Ted1702/First_Repository/prima.jpeg

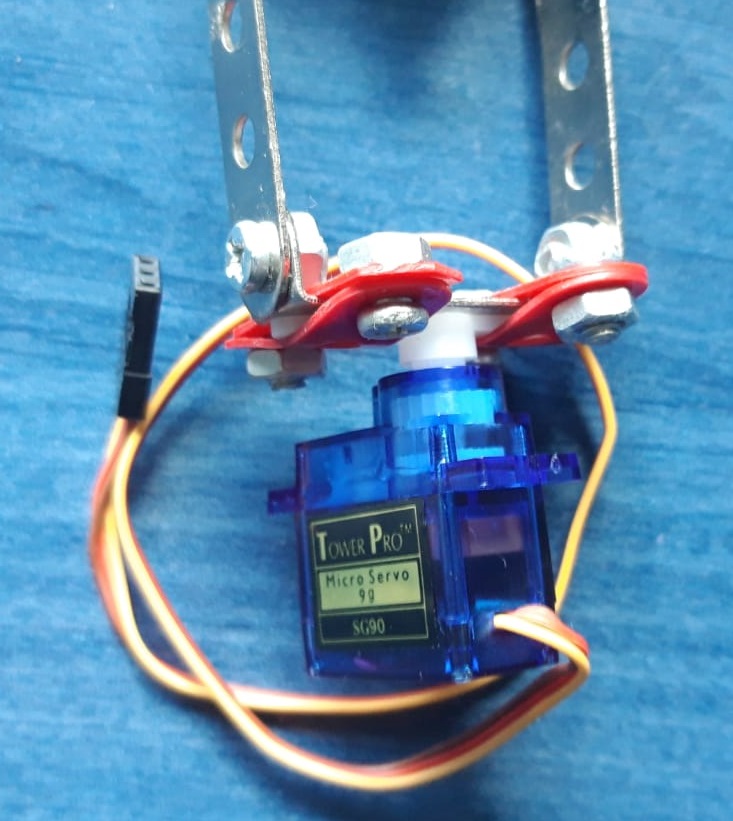
prima.jpeg
