Ted1702/First_Repository/figura 1-3.PNG

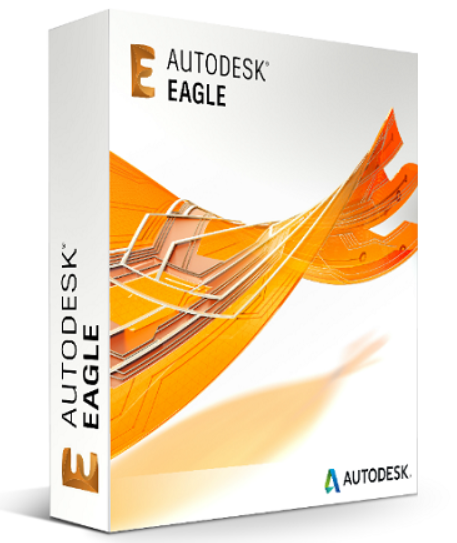
figura 1-3.PNG
