Ted1702/First_Repository/Prezentare_Proiect_Diploma_Lina_Teodor.pptx

Proiect de licență

Robot autonom cu braț mecanic și cameră video

Conducător științific Absolvent
Conf.Dr.Ing. Octaviana DATCU Teodor LINA

## Scopul proiectului și motivația

- Scopul: dezvoltarea unui robot controlat de la distanță capabil de recunoaștere video și îndepărtarea de obstacole.
- Motivația: realizarea unor sisteme hardware comandate de programe software

Notes: Scopul proiectului este reazilarea unui robot capabil să:
Se deplaseze în locuri mai greu accesibile omului
Să poată oferi imagini live de la fața locului
Să poată îndepărta obiecte ușoare care blochează drumul pe unde se dorește deplasarea robotului

Această temă a fost aleasă în scopul creării unui sistem embedded, care îmbină cunoștințele de electronică cu cele de programare.

## Contribuții

- Alegerea componentelor necesare dezvoltării proiectului
- Realizarea schemelor bloc pentru robot și telecomanda cu care se controlează robotul
- Construcția robotului
- Realizarea unui PCB pentru telecomandă
- Construcția brațului mecanic din piese metalice
- Realizarea unor programe software pentru robot și telecomandă

## Slide 4

Diagrama Gantt a proiectului

| Oct. | Nov. | Dec. | Ian. | Feb. | Mar. | Apr. | Mai | Iun.
Planificare inițială
Telecomandă-Schemă electrică
Robot-Schemă electrică
Telecomandă-PCB
Telecomandă-Software
Telecomandă-Asamblare și testare
Construcție braț mecanic
Construcție robot
Robot-Software
Robot-Asablare și testare
Testare sistem
Documentație scrisă

## Scheme Bloc Hardware

- În continuare vor fi detaliate:
1. Schema electrică a telecomenzii
2. Schema electrică a robotului

## Slide 6

Schema electrică a telecomenzii robotului

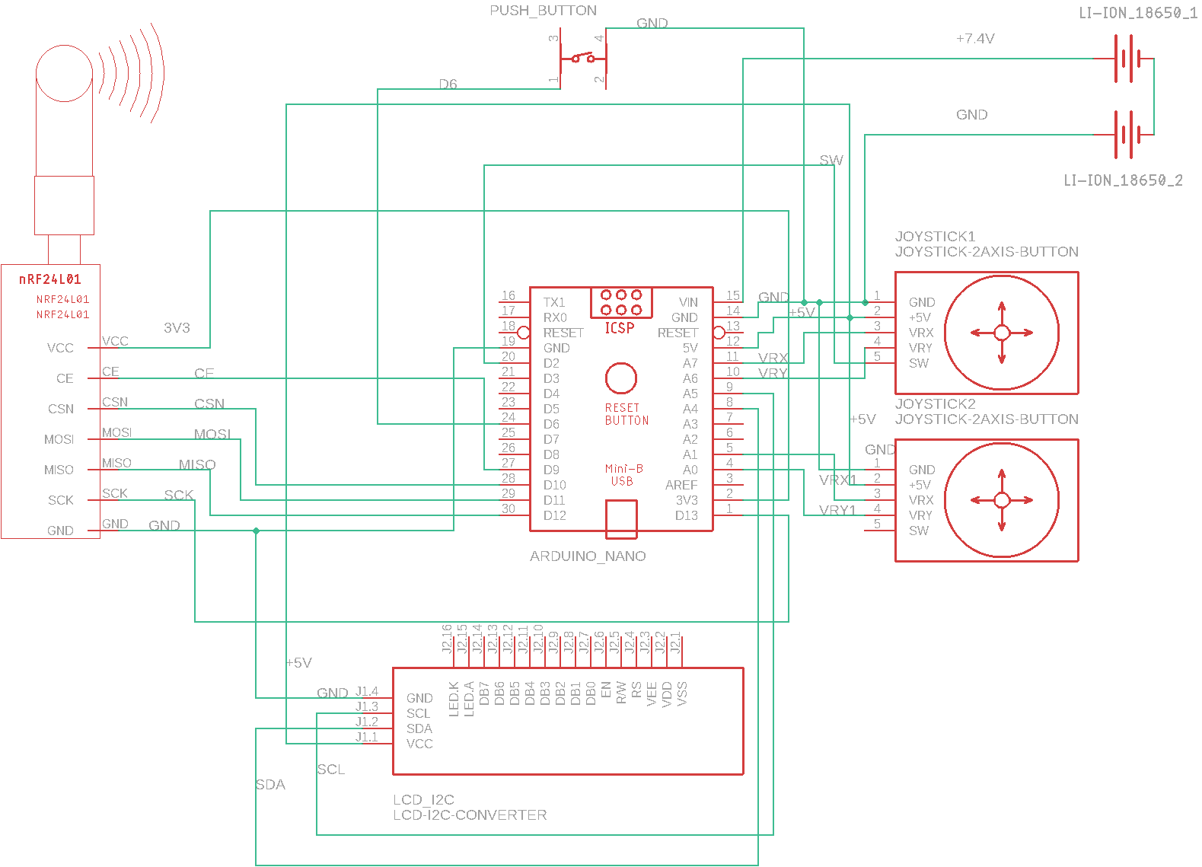
[picture p16: figure]

Sursă alimentare telecomandă

Joystick robot

Joystick braț mecanic

Transmițător radio

Ecran LCD

## Slide 7

Schema electrică a robotului

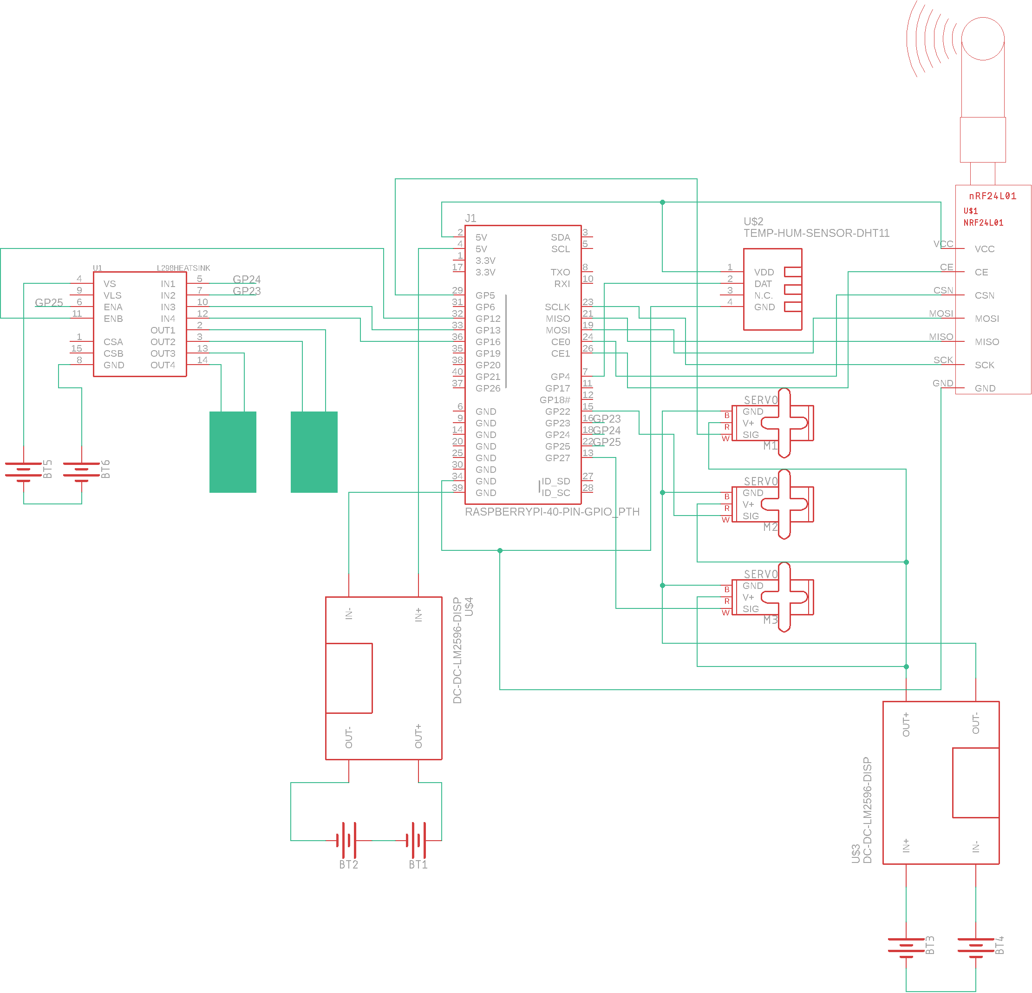
[picture p17: figure]
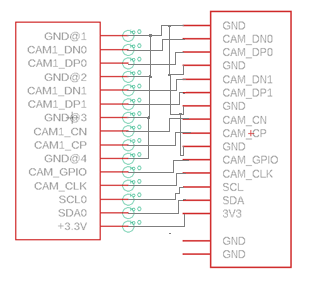
[picture p18: figure]

Transmițător radio

Motoare DC

Coborâtoare de tensiune
LM2596

Sursă alimentare braț mecanic

Sursă alimentare motoare DC

Sursă alimentare Raspberry Pi

## Realizarea comunicației wireless între robot și telecomandă cu ajutorul modulelor NRF24L01+

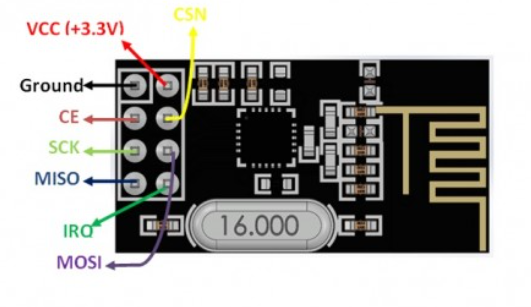
[picture p19: figure]

Protocolul Enhanced Shock Burst

Preambul | Adresă | Control pachet | Conținut pachet | CRC

1 Byte

3-5 Byte

9 Byte

0-32 Byte

1-2 Byte

Lungime conținut pachet | ID pachet | Fără pachet ACK

6 Byte

2 Byte

1 Byte

## Controlul motoarelor DC cu ajutorul punții H duală L298N

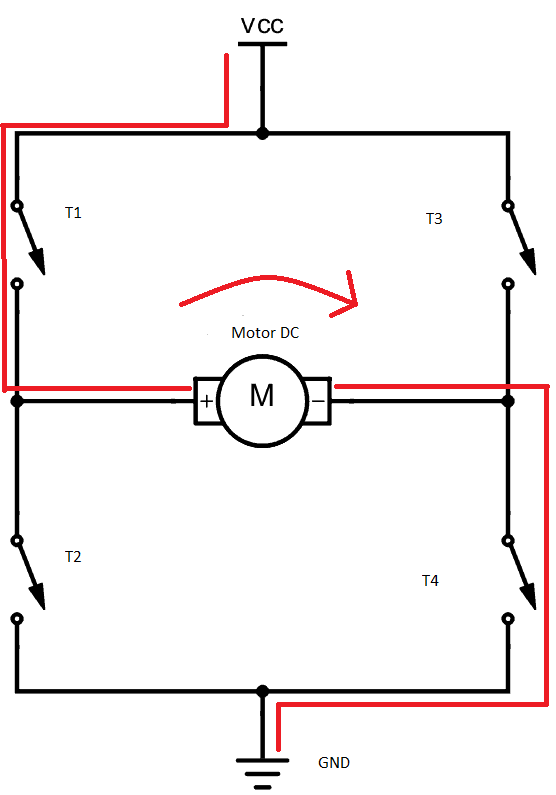
[picture p20: figure]
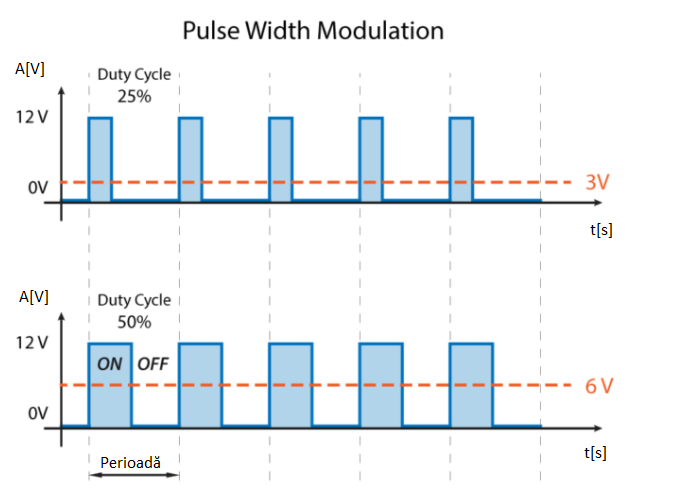
[picture p21: figure]
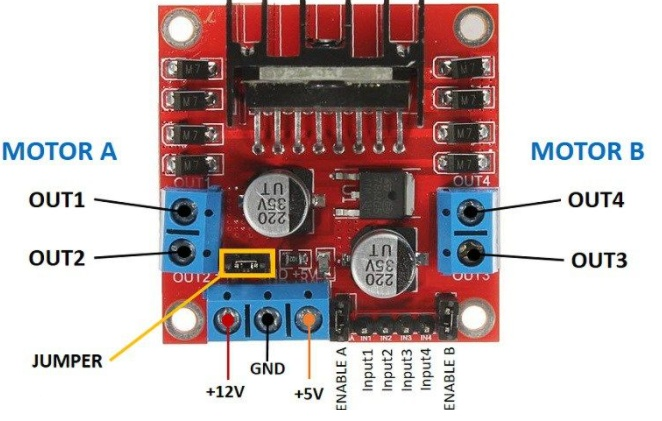
[picture p22: figure]

## Servo-motoarele micro SG90 ale brațului mecanic

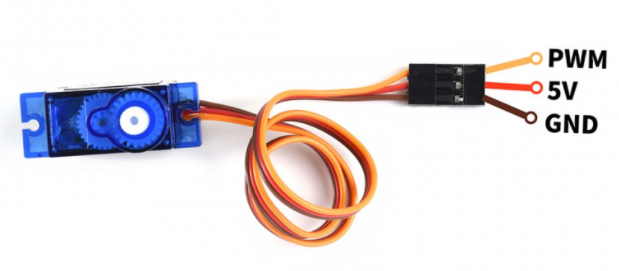
[picture p23: figure]
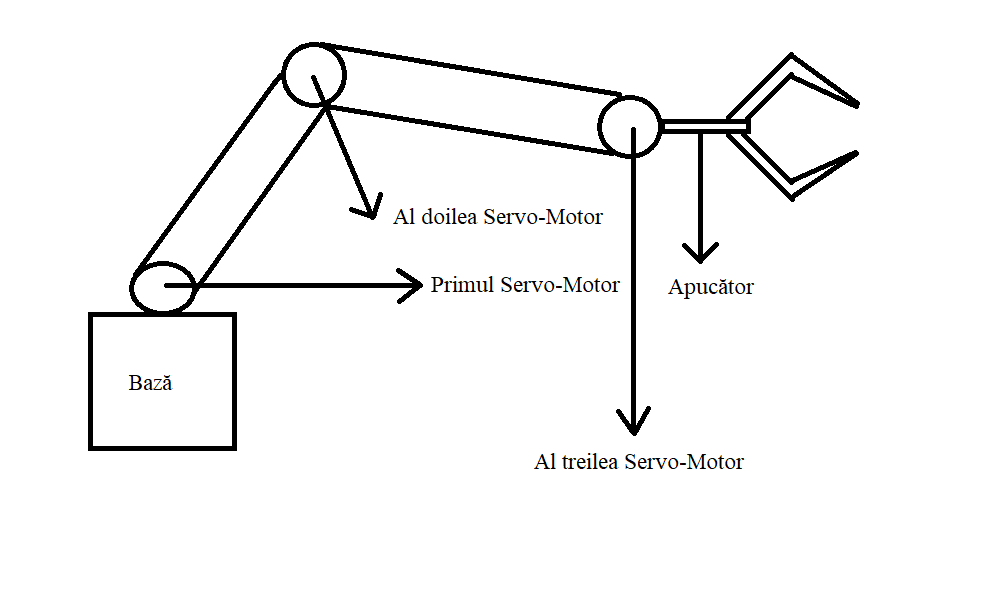
[picture p24: figure]
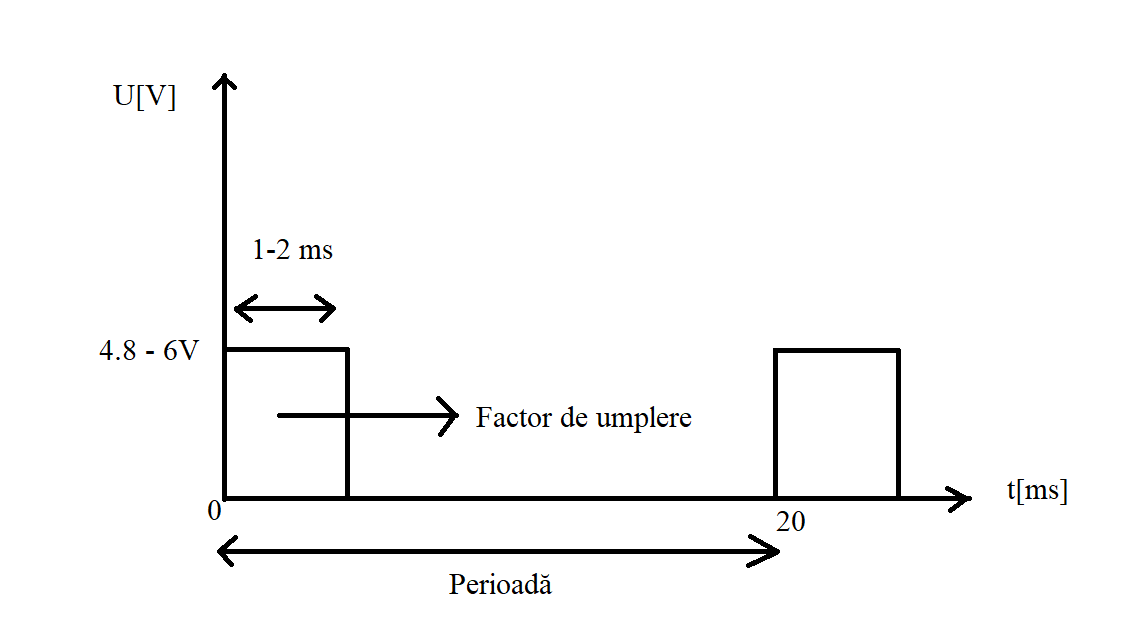
[picture p25: figure]

## Slide 11

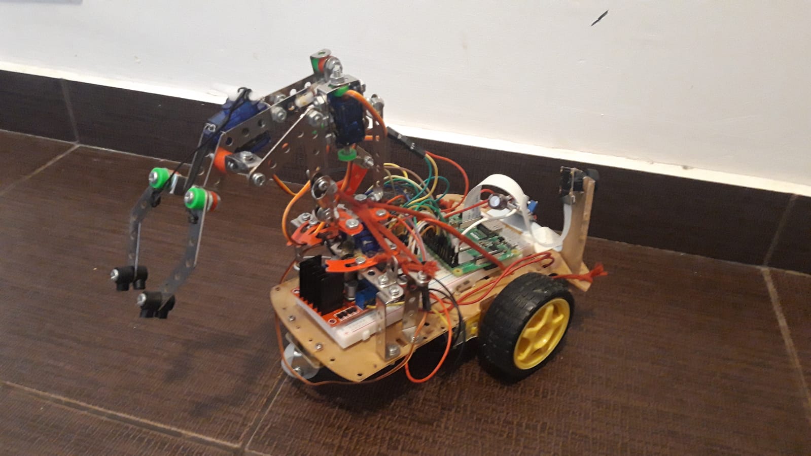
[picture p26: figure]

Machetă Robot

Poziție inițială

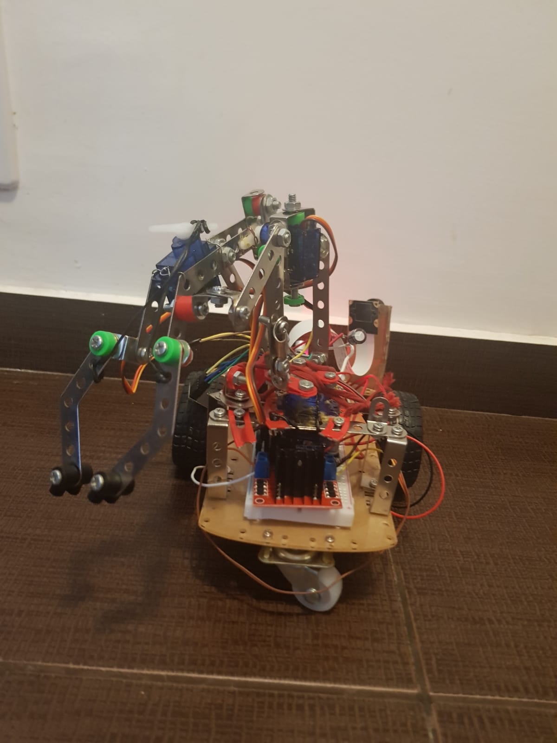
[picture p27: figure]

Deplasare la dreapta

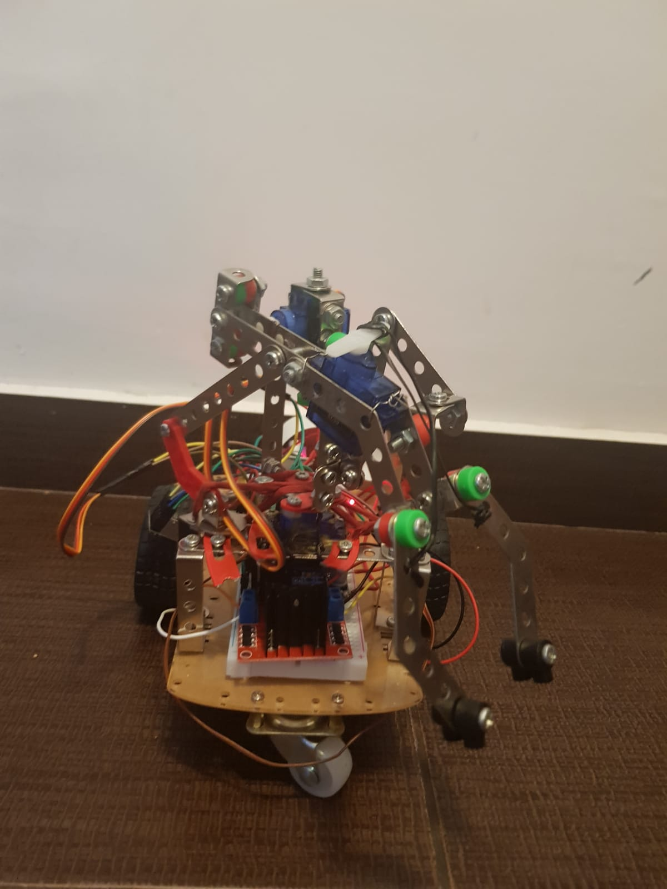
[picture p28: figure]

Deplasare la stânga

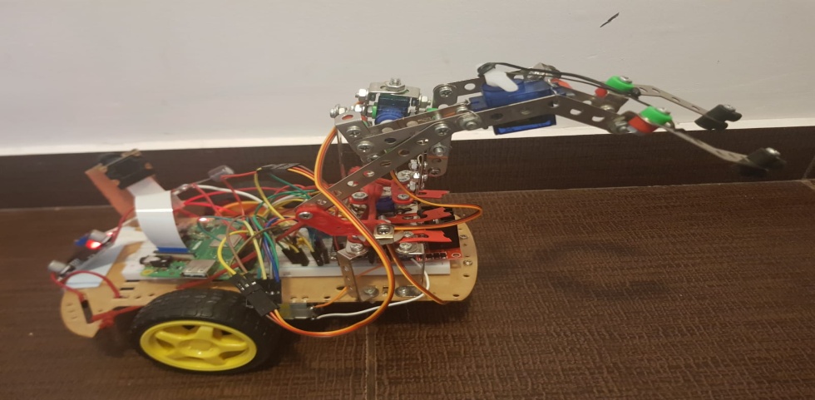
[picture p29: figure]

Deplasare în sus

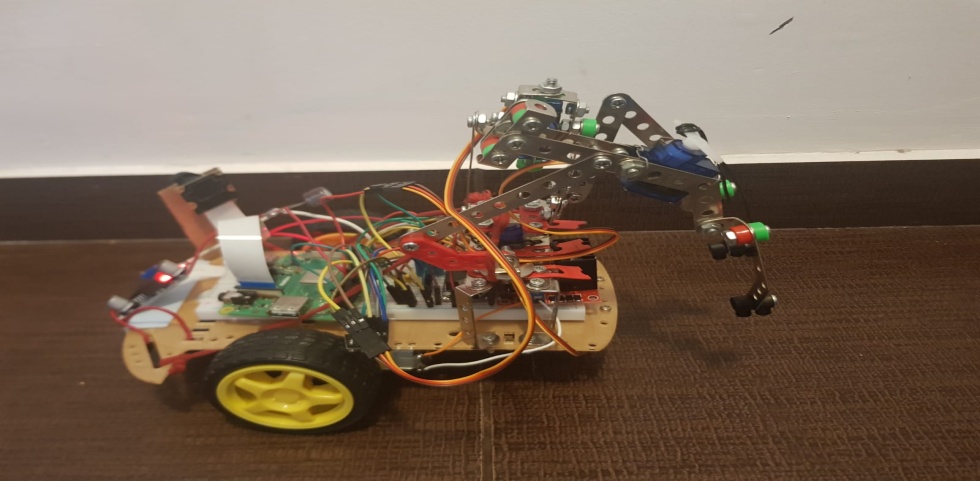
[picture p30: figure]

Deplasare în jos

## Măsurarea temperaturii și umidității cu senzorul digital DHT 11

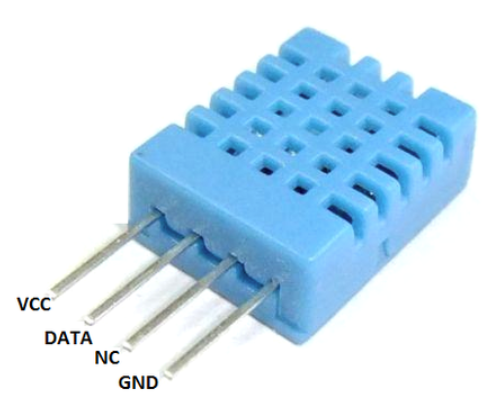
[picture p31: figure]
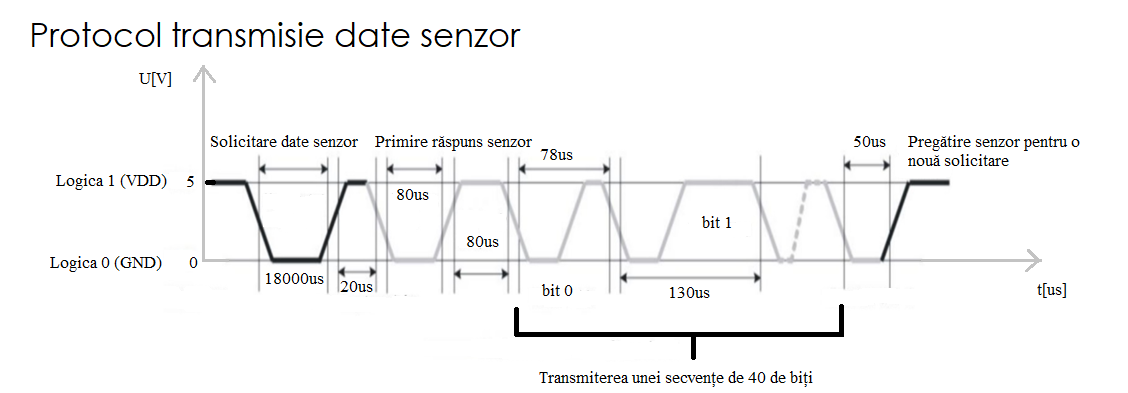
[picture p32: figure]

## Video stream realizat cu un modul de cameră compatibil cu Raspberry Pi

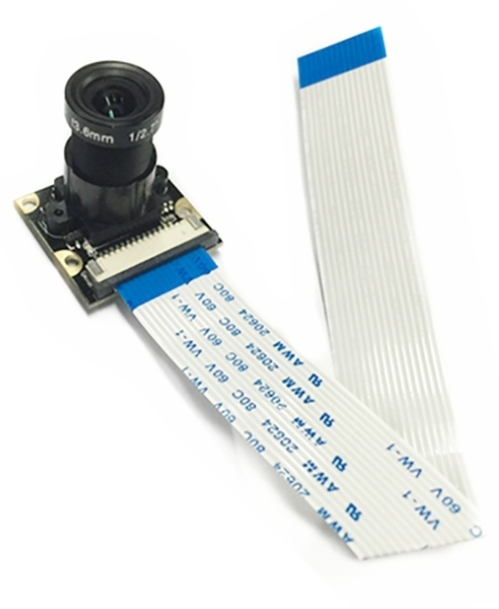
[picture p33: figure]

- format MJPEG
- 24 cadre/secundă
- rezoluție de 640x480 pixeli
- debit binar 1MB/secundă

## Organigrama codului sursă

Telecomandă

Start

Robot

Start

Inițializare cameră video

Redare stream video

Pregătire NRF24l01+

Buton apăsat

Pregătire NRF24l01+

DA

DA

Trimitere mesaj ’’stop’’

Recepționare mesaj ’’stop’’

Trimitere date senzor DHT11

NU

NU

Recepționare coordonate
de deplasare

Recepționare date de la robot

Trimitere coordonate de deplasare

Afișarea datelor recepționate.

Deplasare robot/braț mecanic

## Slide 15

Pachetele de date transmise între robot și telecomandă

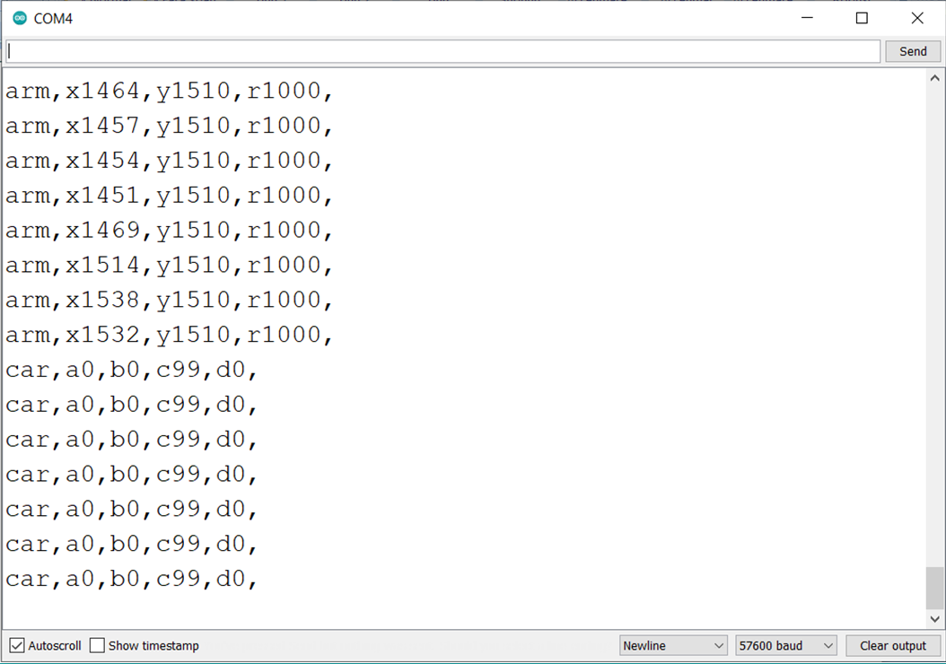
[picture p34: figure]
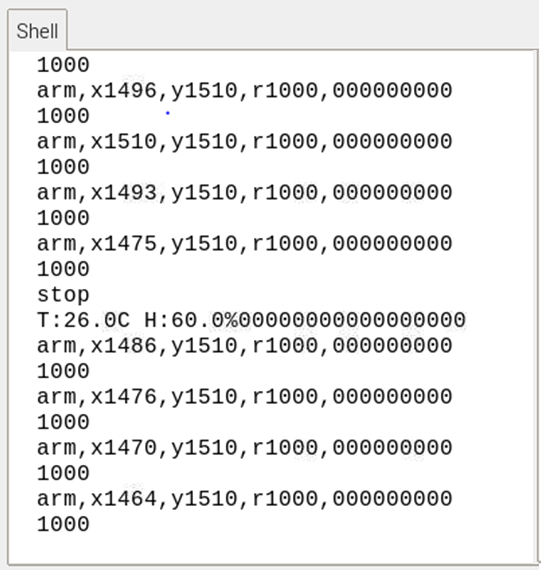
[picture p35: figure]

## Slide 16

Demonstrație funcționalități robot

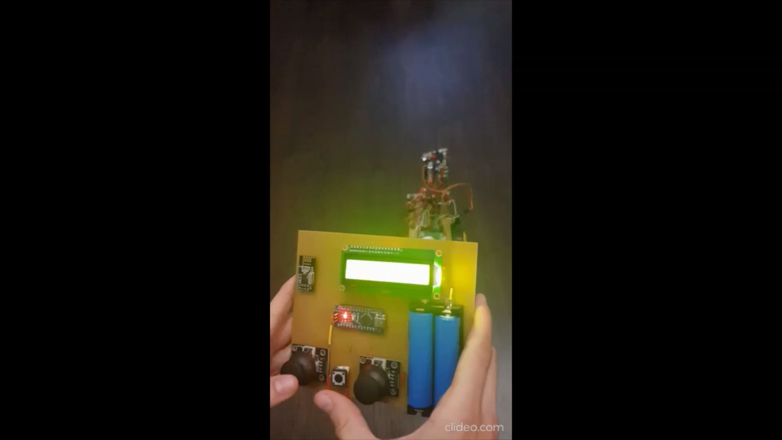
[picture p36: figure]

## Concluzii

Îndeplinirea obiectivului propus, după rezolvarea problemelor apărute:
- alimentarea de 3.3V a transmițătorului NRF24L01+
- alimentarea de 5V a plăcii de dezvoltare Raspberry Pi
- corecția mișcării servo-motoare SG90
- corecția suportului de acumulatori la PCB-ul telecomenzii
- corecția suportului de braț mecanic
