Ted1702/First_Repository/2021_Licenta_Inscriere_Teodor_LINA.docx

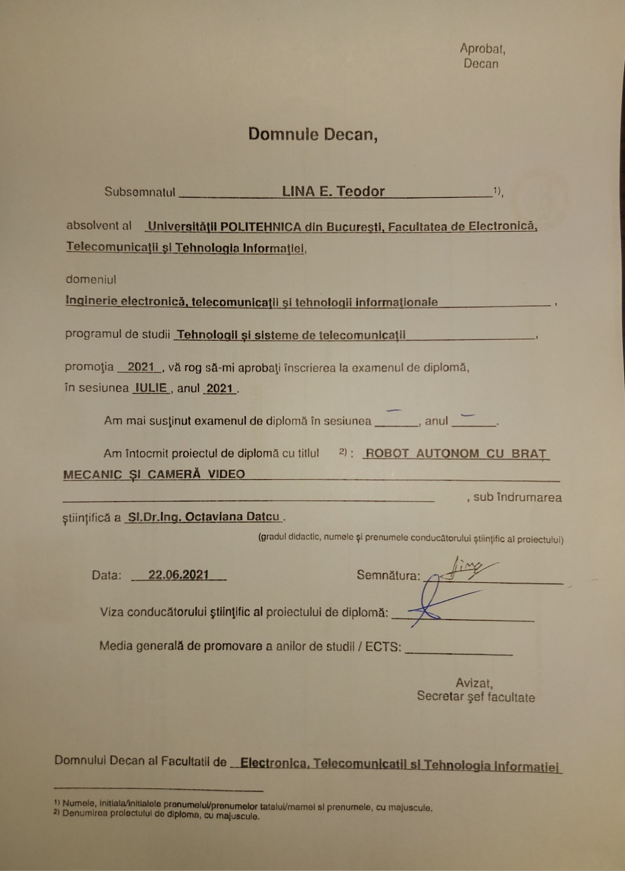
[picture p41: figure]
file:///C:/Users/User/Downloads/2021_Licenta_Inscriere_Teodor_LINA
