Ted1702/First_Repository/1-12.png

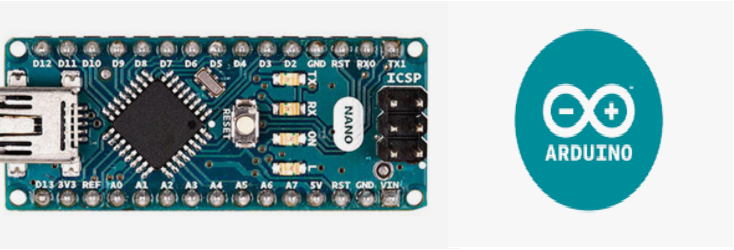
1-12.png
