Ted1702/First_Repository/1-19.png

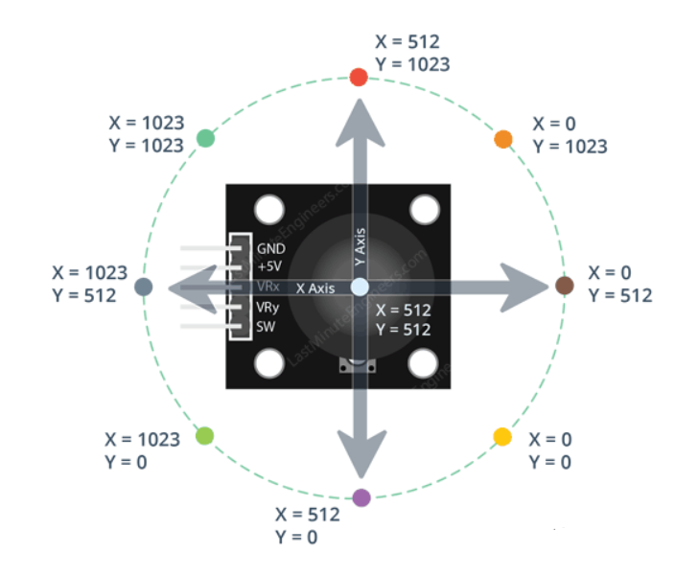
1-19.png
