Ted1702/First_Repository/3-3.png

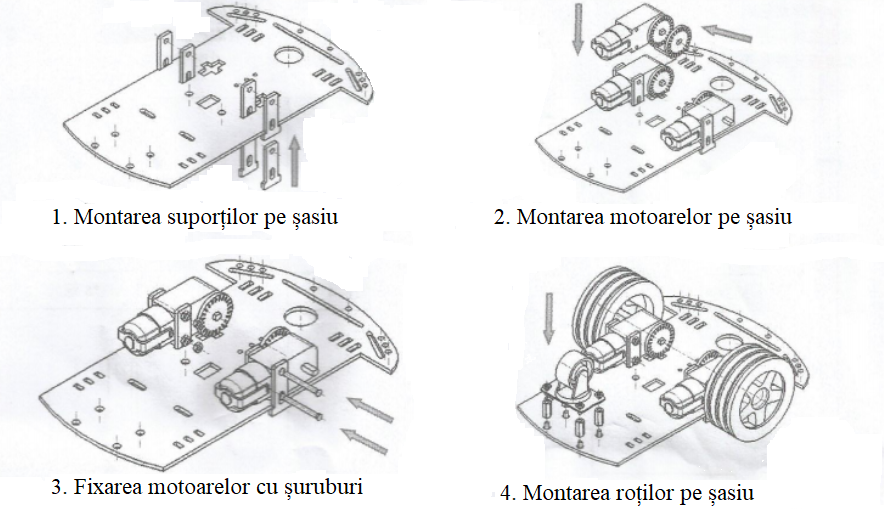
3-3.png
