Ted1702/First_Repository/doua.jpeg

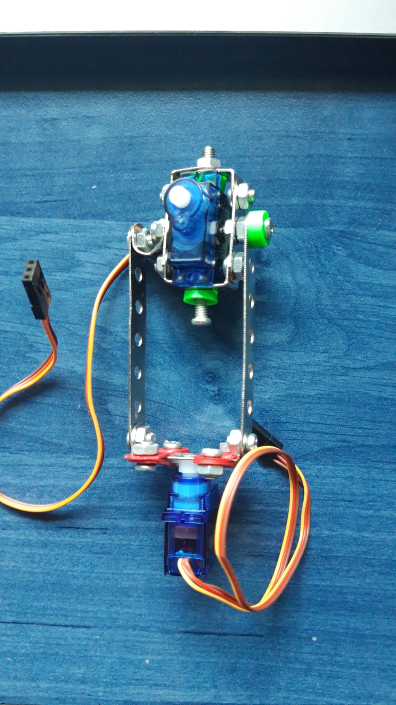
doua.jpeg
