Ted1702/First_Repository/figura1-13.png

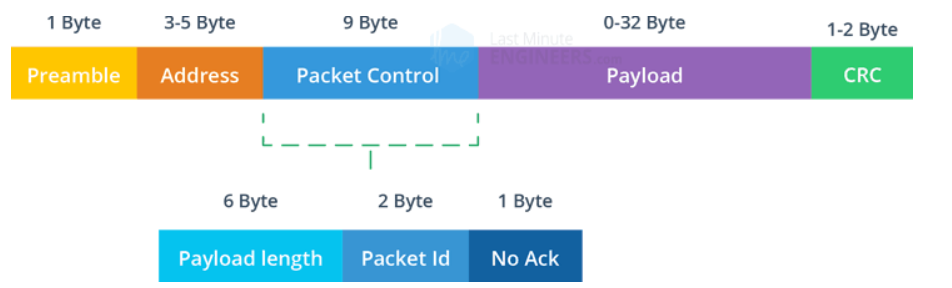
figura1-13.png
