Ted1702/First_Repository/figura1-15.png

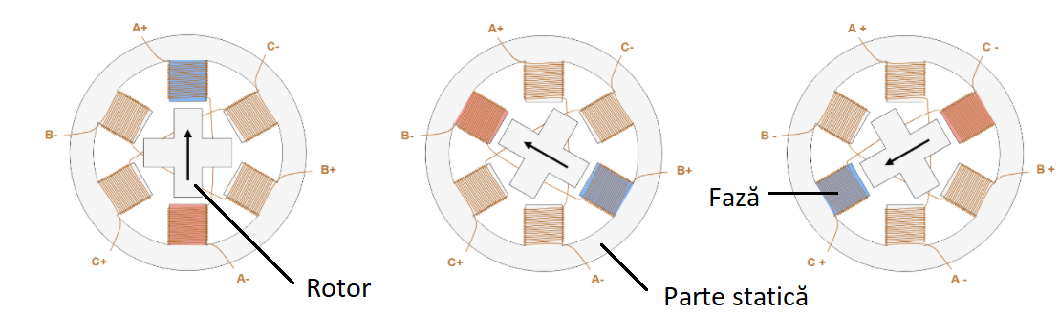
figura1-15.png
