Ted1702/First_Repository/figura 2-2.png

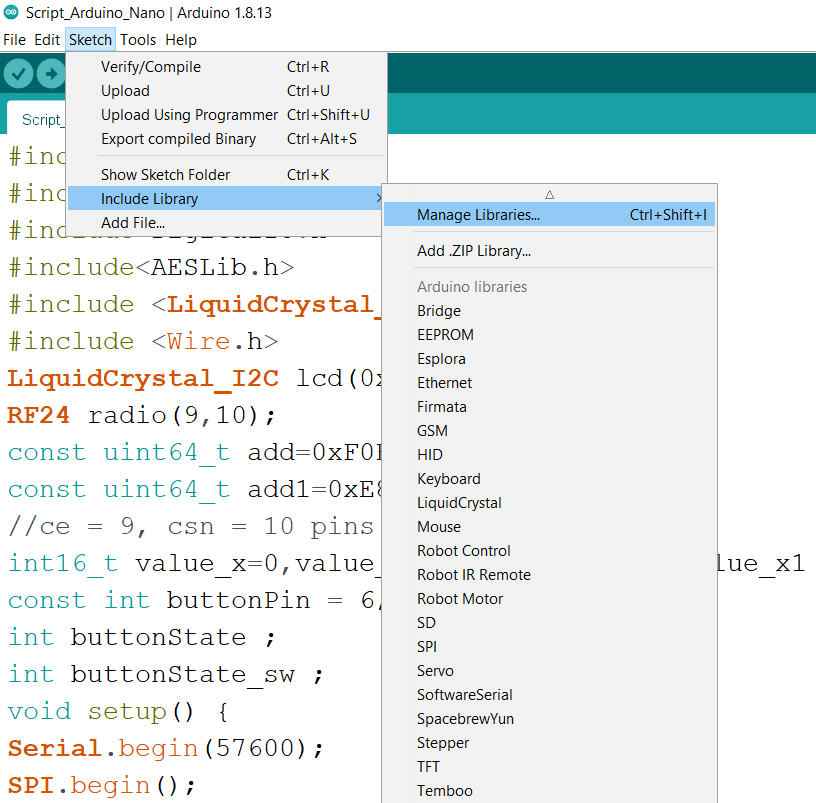
figura 2-2.png
