Ted1702/First_Repository/figura 2-3.png

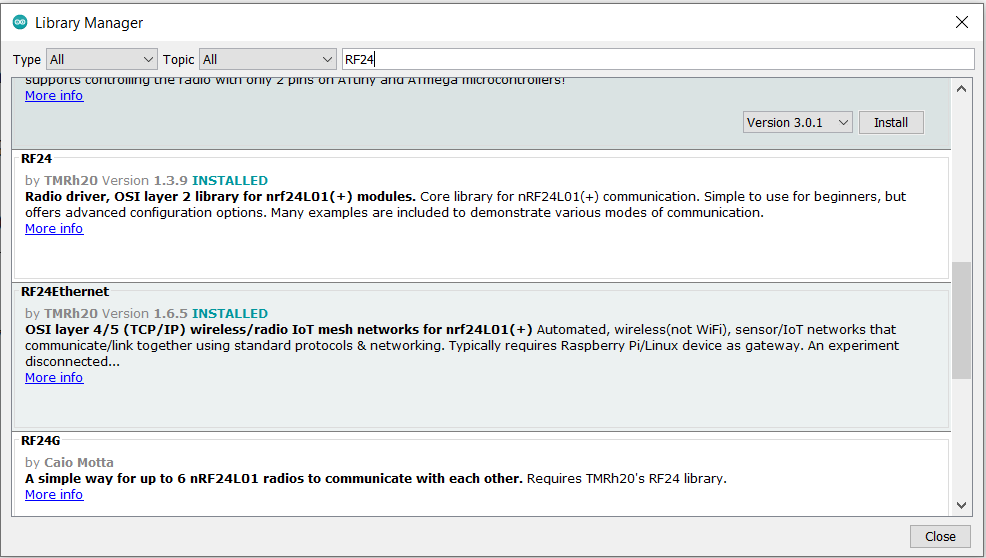
figura 2-3.png
