Ted1702/First_Repository/figura 2-4.png

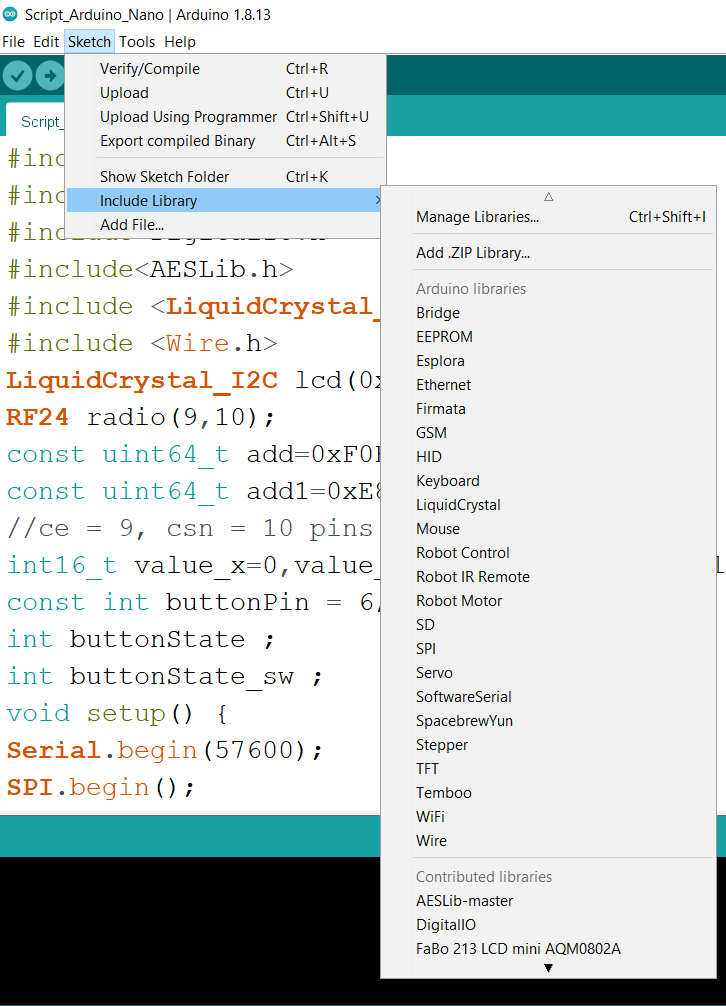
figura 2-4.png
