Ted1702/First_Repository/imagine_board.PNG

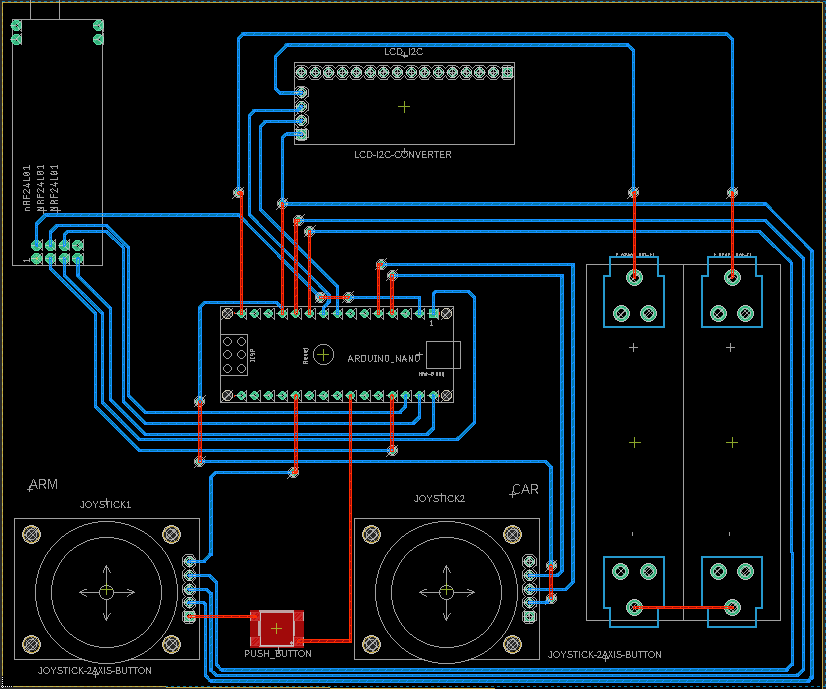
imagine_board.PNG
