Ted1702/First_Repository/lcdu.png

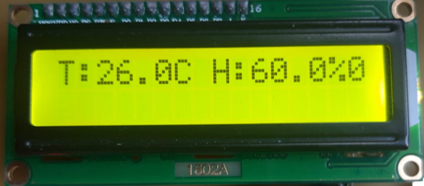
lcdu.png
