Ted1702/First_Repository/LINA Teodor_Confirmare_chestionar.png

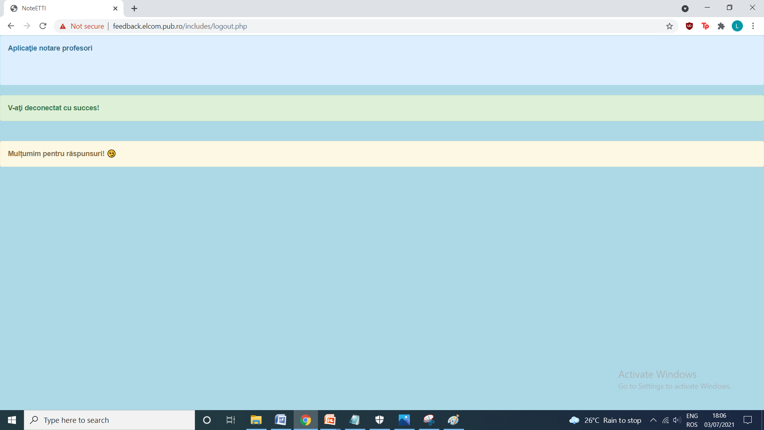
LINA Teodor_Confirmare_chestionar.png
