Ted1702/First_Repository/Lina_Teodor.jpeg

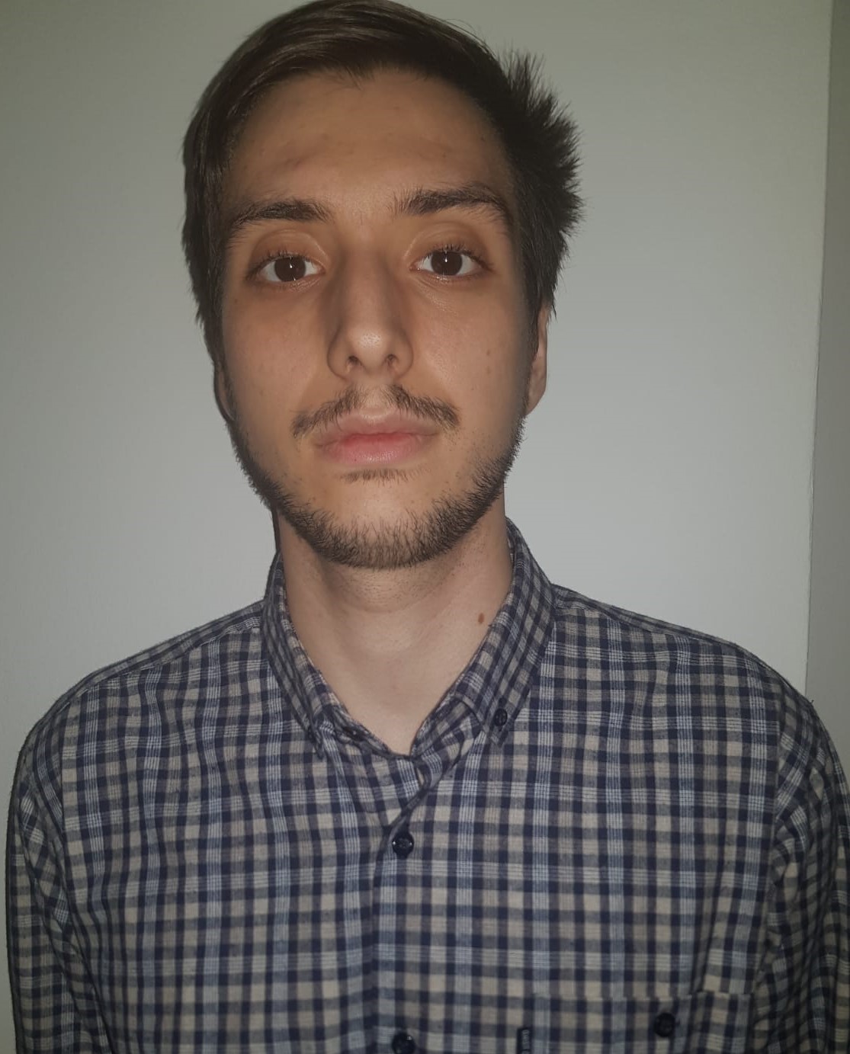
Lina_Teodor.jpeg
