Ted1702/First_Repository/livestream.jpg

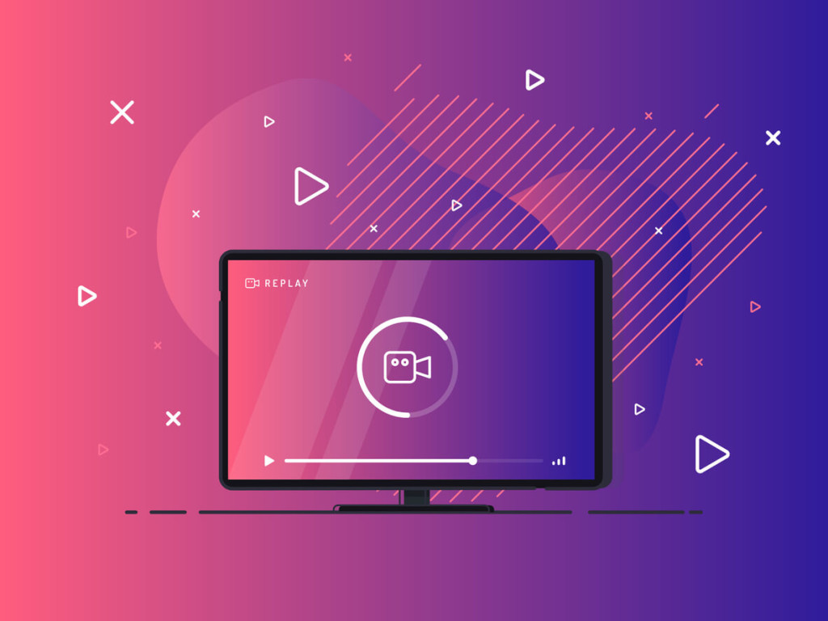
livestream.jpg
