Ted1702/First_Repository/lm2596.jpeg

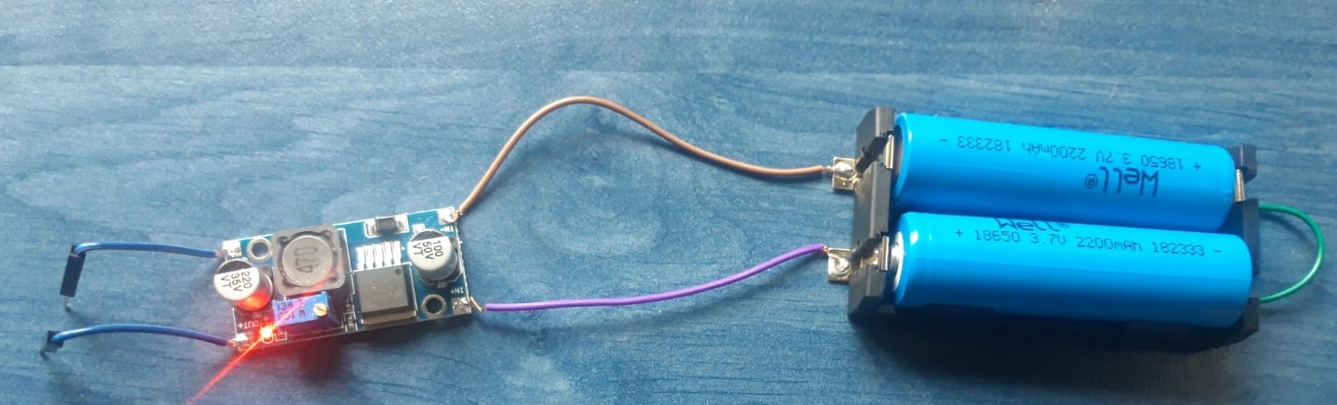
lm2596.jpeg
