Ted1702/First_Repository/Masina.png

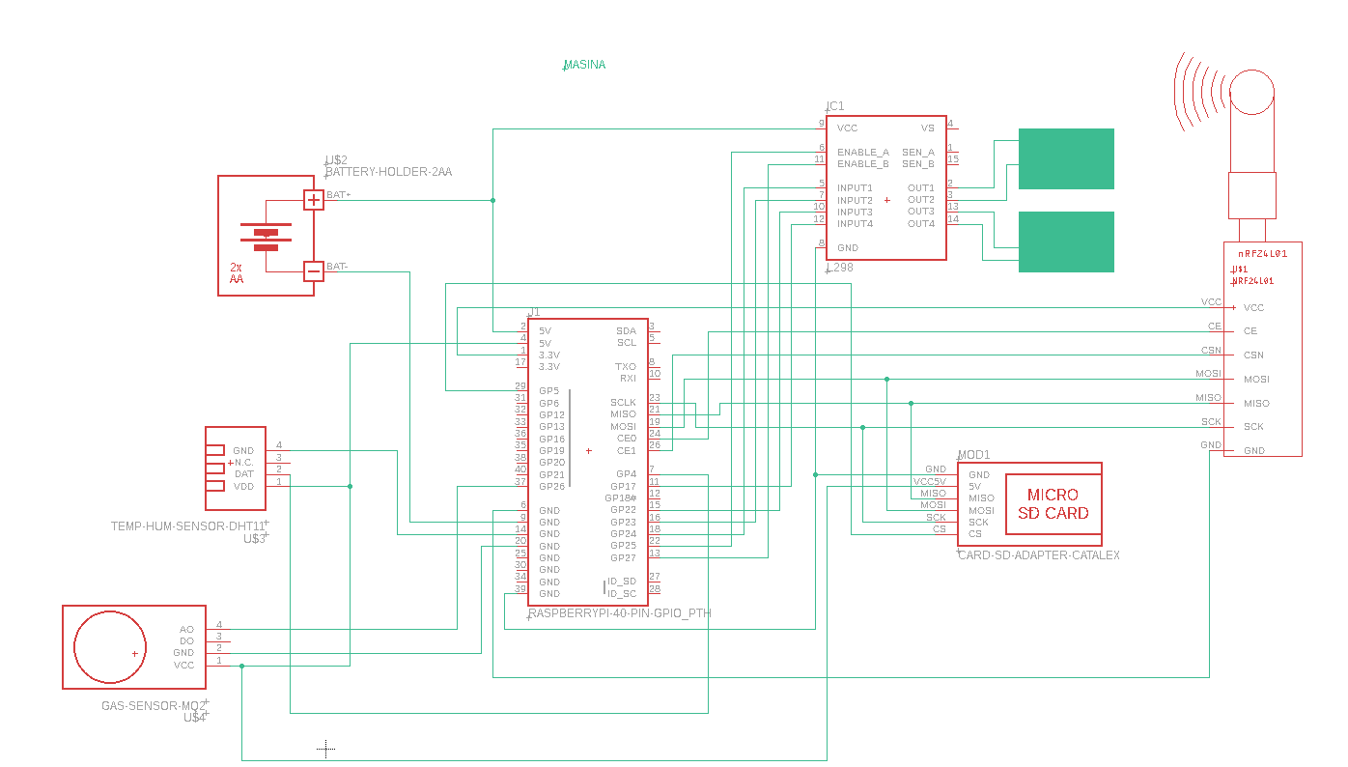
Masina.png
