Ted1702/First_Repository/poza_pozelor.png

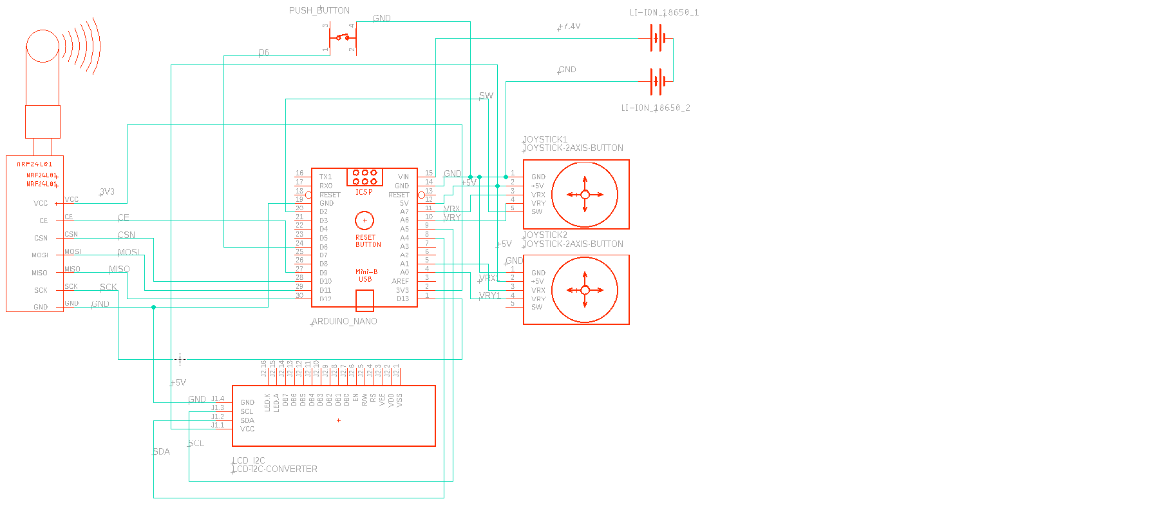
poza_pozelor.png
