Ted1702/First_Repository/Poza_telecomanda_completa.jpeg

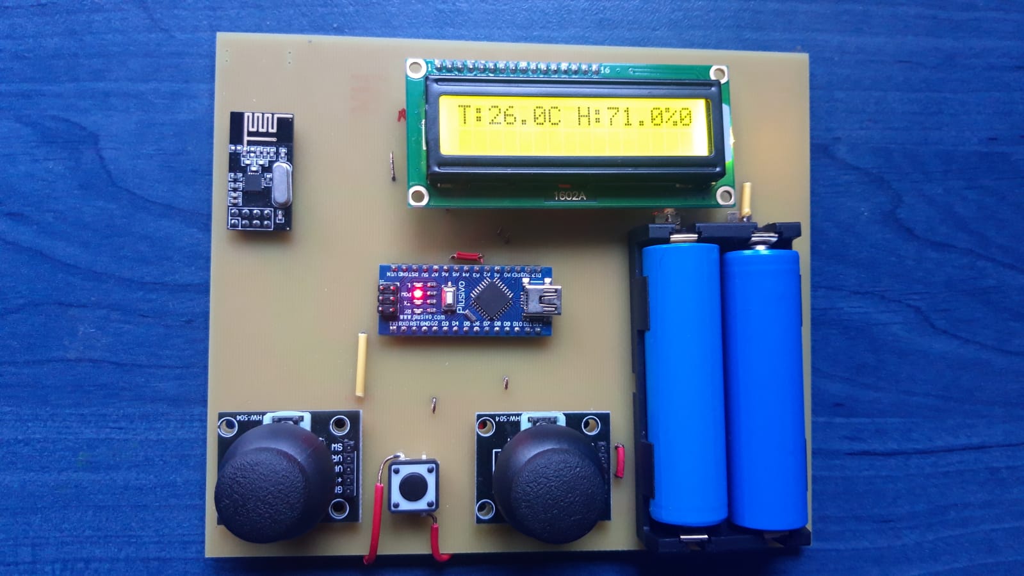
Poza_telecomanda_completa.jpeg
