Ted1702/First_Repository/Tabel1.PNG

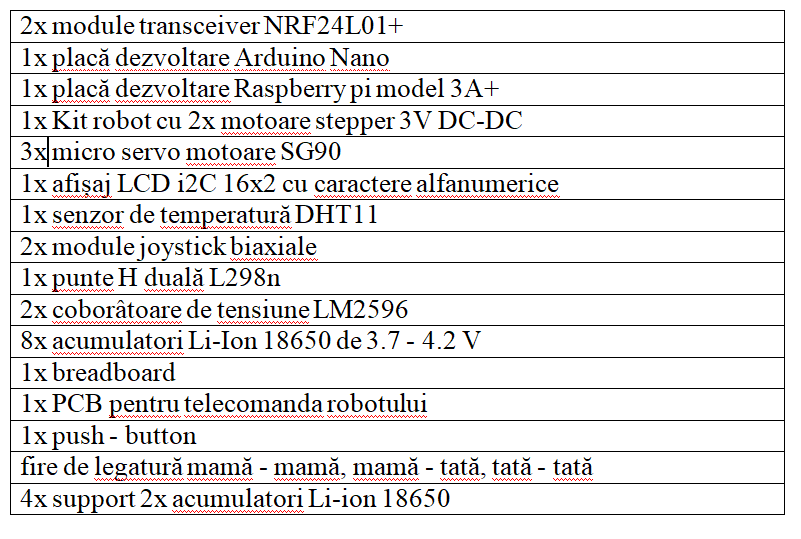
Tabel1.PNG
