Ted1702/First_Repository/tot.jpeg

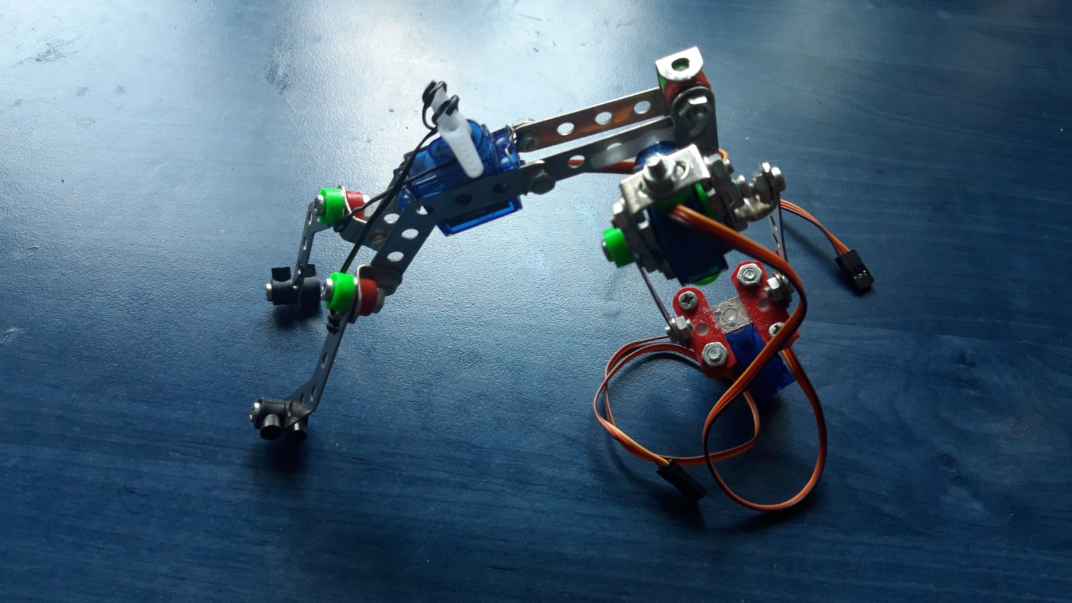
tot.jpeg
