Ted1702/First_Repository/treia.jpeg

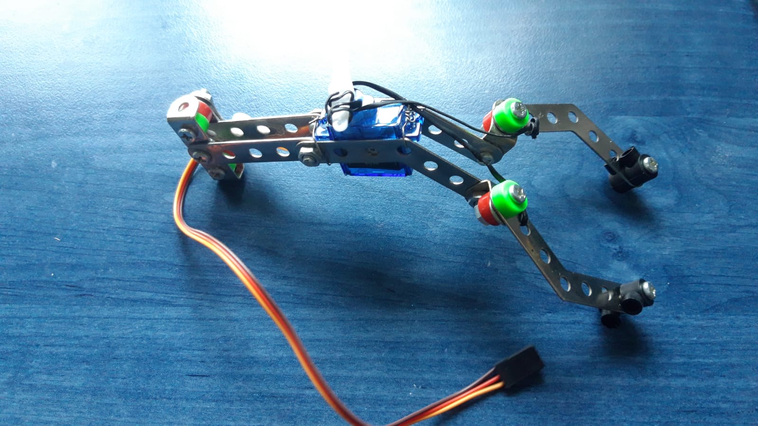
treia.jpeg
