Ted1702/First_Repository/Untitled.png

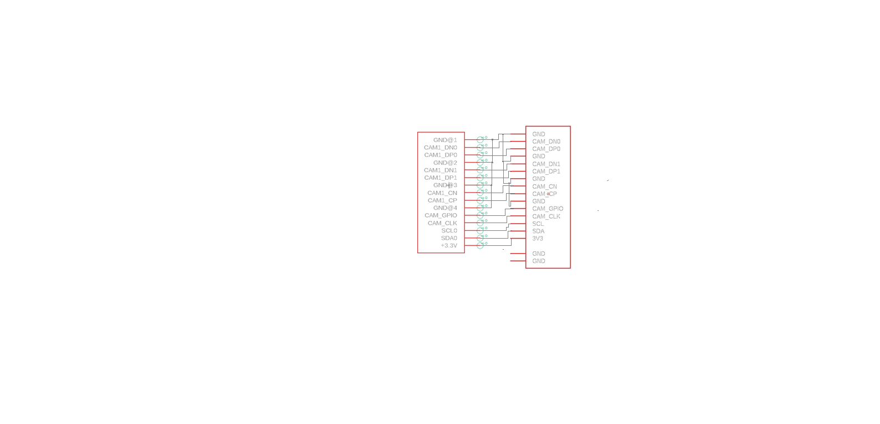
Untitled.png
