Ted1702/First_Repository/Telecomanda_Licenta.brd

## EAGLE design Telecomanda_Licenta.brd (2021-11-25)

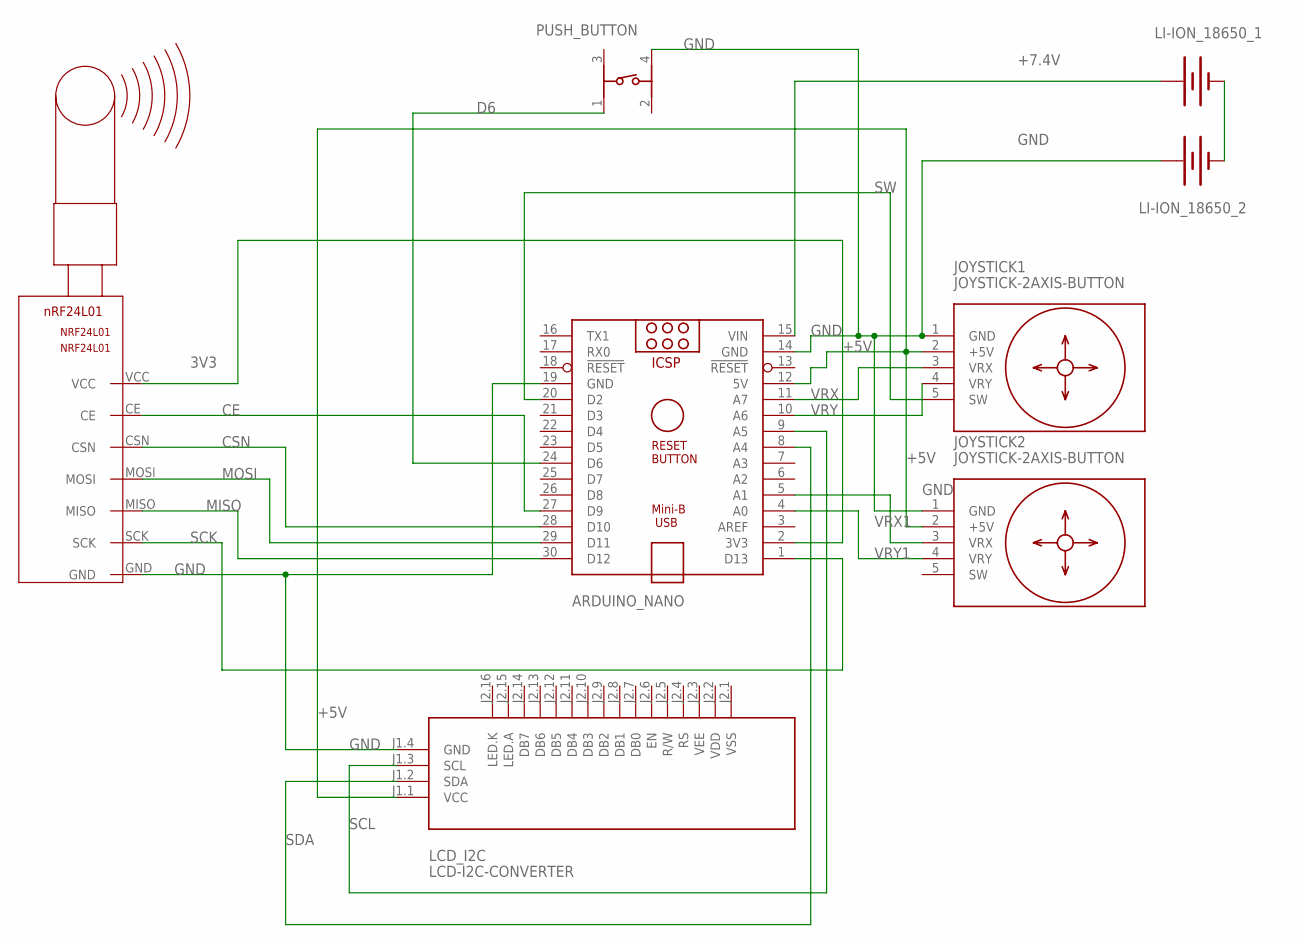
[picture p64: schematic Telecomanda_Licenta.sch]

Parts:
ARDUINO_NANO: ARDUINO_NANO
JOYSTICK1, JOYSTICK2: JOYSTICK-2AXIS-BUTTON
LCD_I2C: LCD-I2C-CONVERTER
LI-ION_18650_1, LI-ION_18650_2: BATTERY-18650; BATTERY_18650-HOLDER
NRF24L01: NRF24L01
PUSH_BUTTON: 430152050836

Connections:
3V3: ARDUINO_NANO.2 (3V3), NRF24L01.VCC
+5V: ARDUINO_NANO.12 (5V), JOYSTICK1.2 (+5V), JOYSTICK2.2 (+5V), LCD_I2C.J1.1 (VCC)
+7.4V: ARDUINO_NANO.15 (VIN), LI-ION_18650_1.PWR@1 (+)
CE: ARDUINO_NANO.27 (D9), NRF24L01.CE
CSN: ARDUINO_NANO.28 (D10), NRF24L01.CSN
D6: ARDUINO_NANO.24 (D6), PUSH_BUTTON.1
GND: ARDUINO_NANO.14 (GND), ARDUINO_NANO.19 (GND), JOYSTICK1.1 (GND), JOYSTICK2.1 (GND), LCD_I2C.J1.4 (GND), LI-ION_18650_2.PWR@1 (+), NRF24L01.GND, PUSH_BUTTON.4
MISO: ARDUINO_NANO.30 (D12), NRF24L01.MISO
MOSI: ARDUINO_NANO.29 (D11), NRF24L01.MOSI
unnamed: LI-ION_18650_1.GND@1 (-), LI-ION_18650_2.GND@1 (-)
SCK: ARDUINO_NANO.1 (D13), NRF24L01.SCK
SCL: ARDUINO_NANO.9 (A5), LCD_I2C.J1.3 (SCL)
SDA: ARDUINO_NANO.8 (A4), LCD_I2C.J1.2 (SDA)
SW: ARDUINO_NANO.20 (D2), JOYSTICK1.5 (SW)
VRX: ARDUINO_NANO.11 (A7), JOYSTICK1.3 (VRX)
VRX1: ARDUINO_NANO.5 (A1), JOYSTICK2.3 (VRX)
VRY: ARDUINO_NANO.10 (A6), JOYSTICK1.4 (VRY)
VRY1: ARDUINO_NANO.4 (A0), JOYSTICK2.4 (VRY)

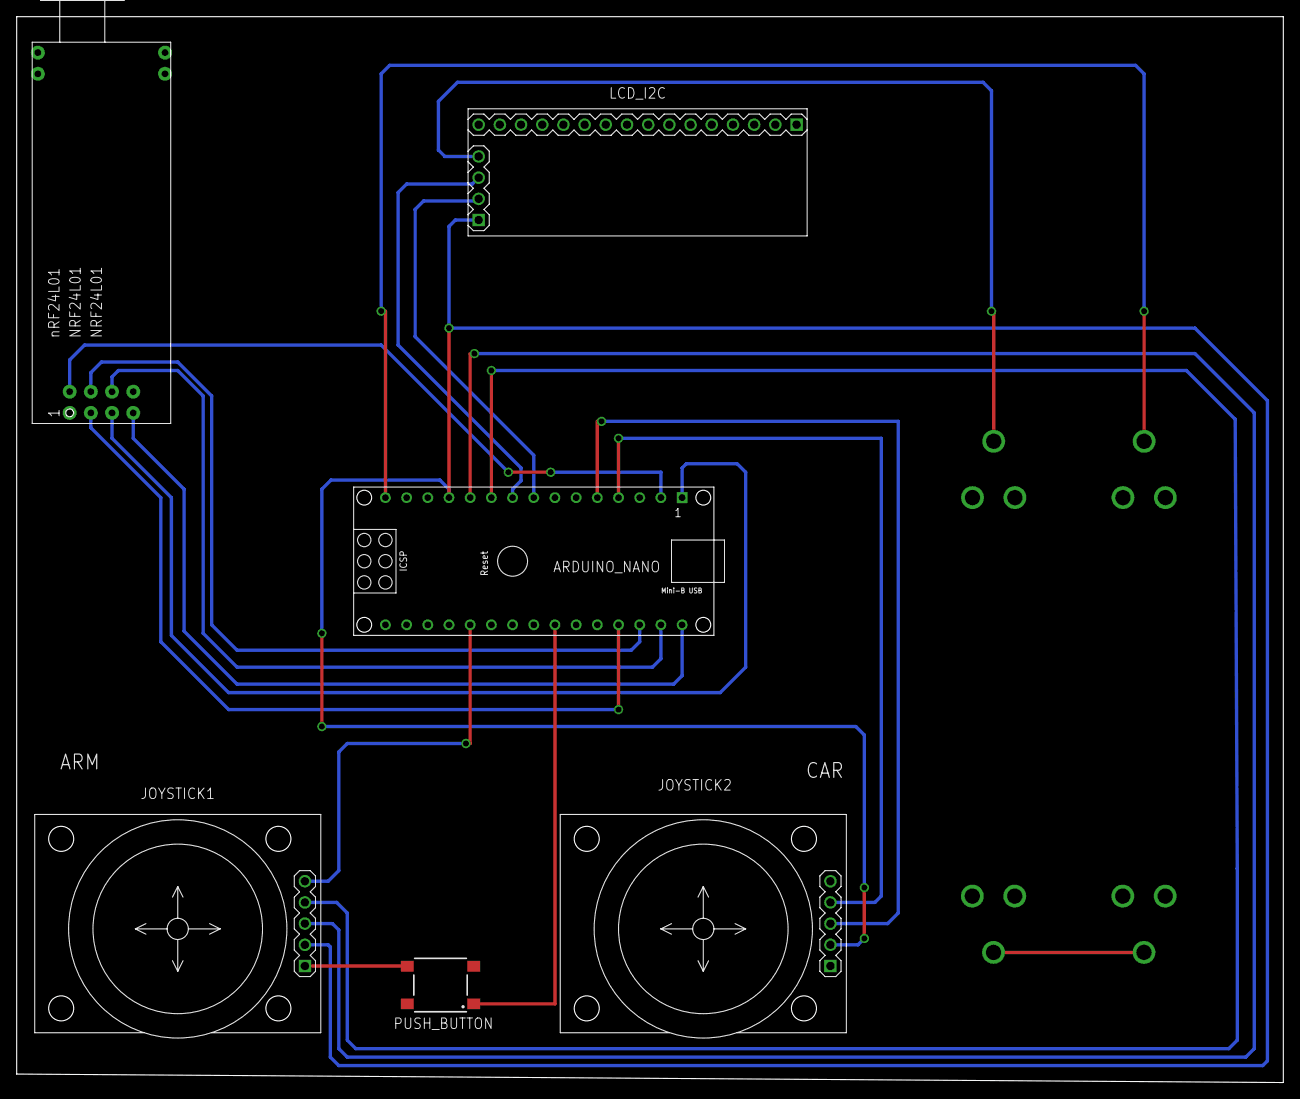
[picture p65: board Telecomanda_Licenta.brd from above]

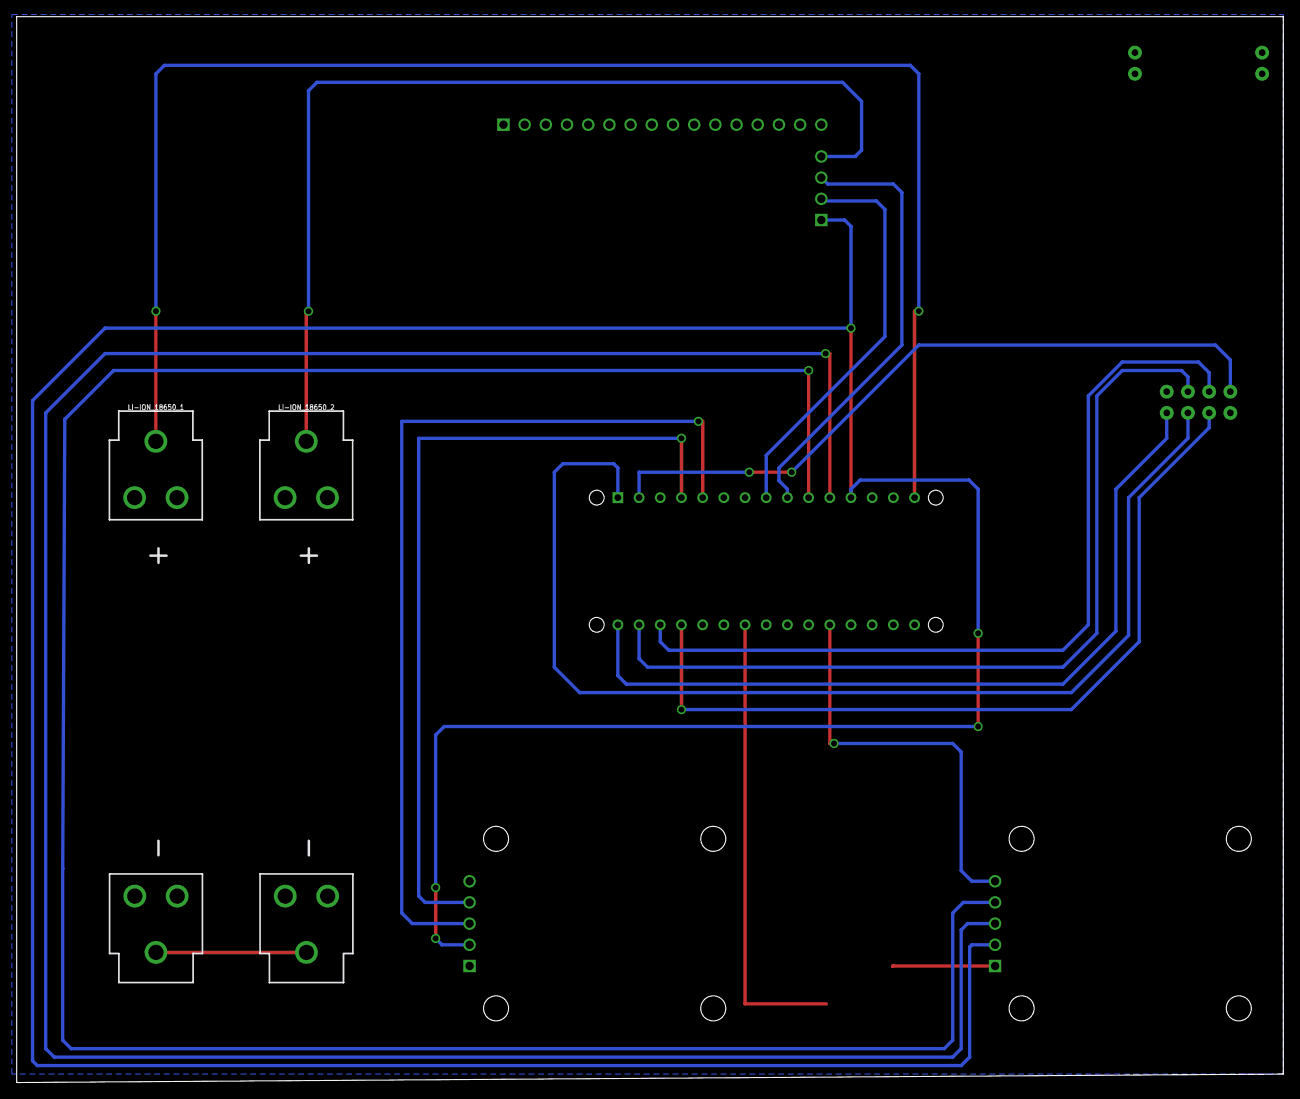
[picture p66: board Telecomanda_Licenta.brd from below]

Board: 2 copper layers, 151.8 x 127.8 mm, 8 parts (2 on the bottom side), 18 nets.
