Ted1702/First_Repository/(notices)

Notices in the files:
parts and their libraries:
diy-modules: Released under the Creative Commons Attribution 4.0 International License: http://creativecommons.org/licenses/by/4.0
Wurth_Switch_WS-TASV: Copyright: Würth Elektronik
